Cbturtle2/Location-Declaration-System/Location Declaration System/ID.jpg

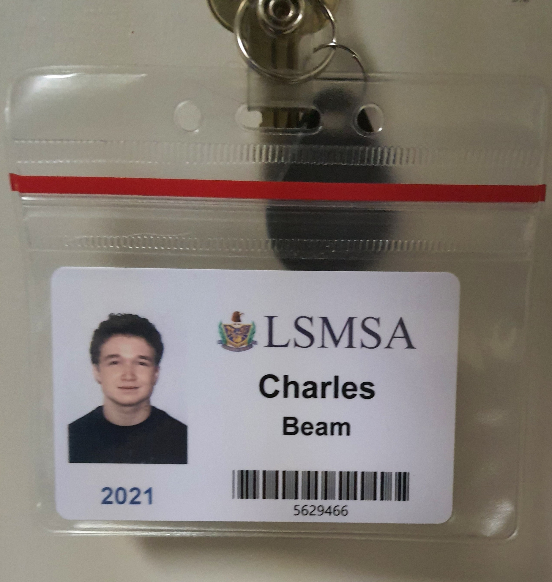
Location Declaration System/ID.jpg
