Cbturtle2/Location-Declaration-System/Location Declaration System/Presenting IBM.jpg

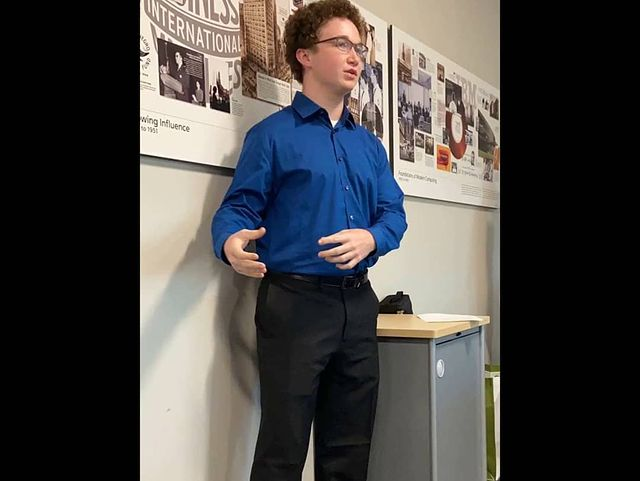
Location Declaration System/Presenting IBM.jpg
