Cbturtle2/Location-Declaration-System/Location Declaration System/RFID Box Inside.jpg

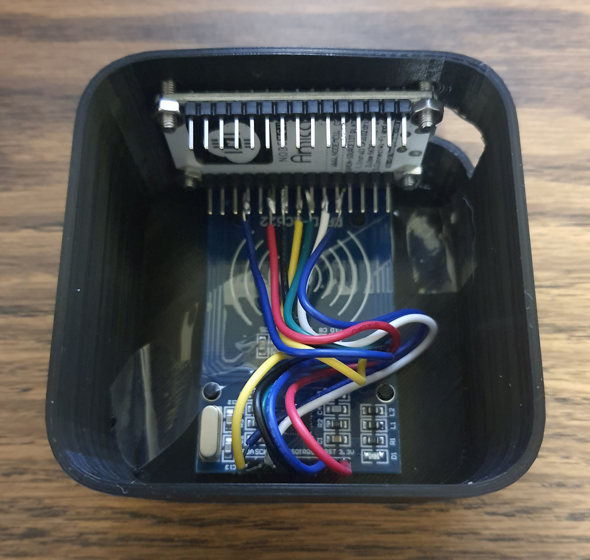
Location Declaration System/RFID Box Inside.jpg
