Cbturtle2/Location-Declaration-System/Location Declaration System/RFID Box LED Angled.jpg

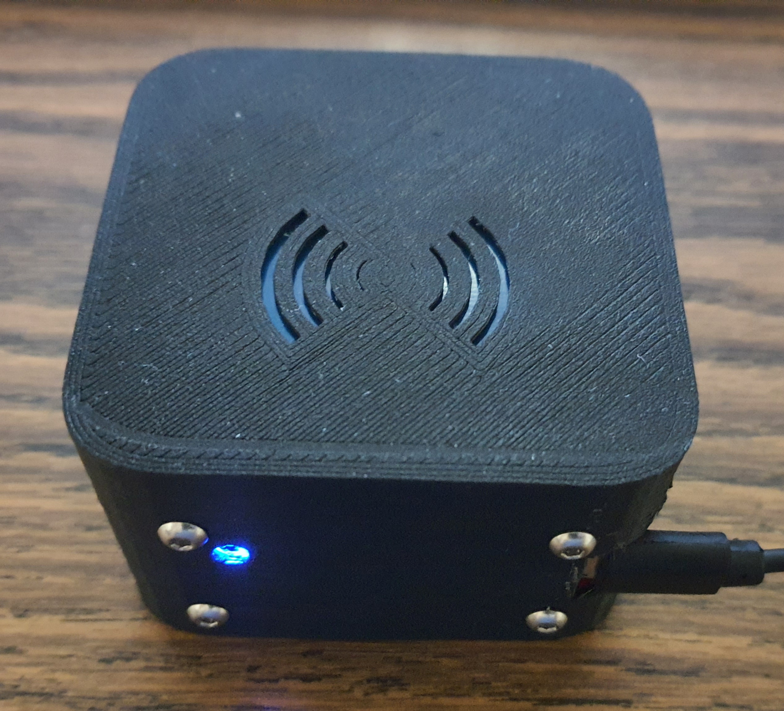
Location Declaration System/RFID Box LED Angled.jpg
