Cbturtle2/Location-Declaration-System/Location Declaration System/RFID Box LED Side.jpg

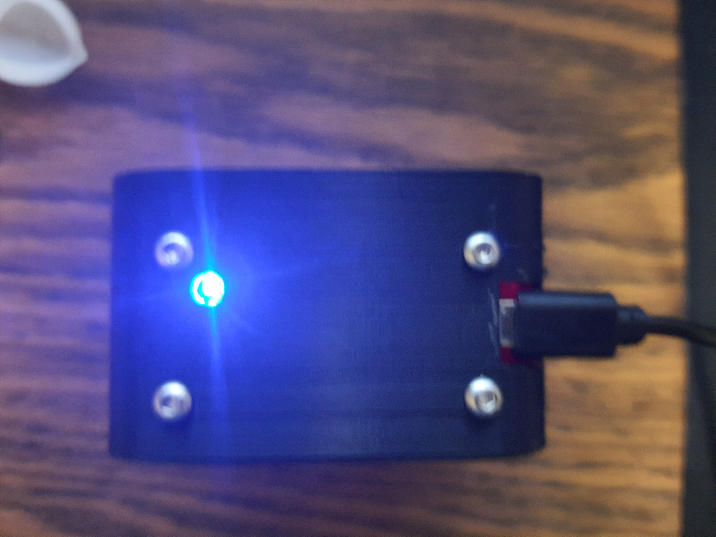
Location Declaration System/RFID Box LED Side.jpg
