Cbturtle2/Location-Declaration-System/Location Declaration System/RFID Box no Box.jpg

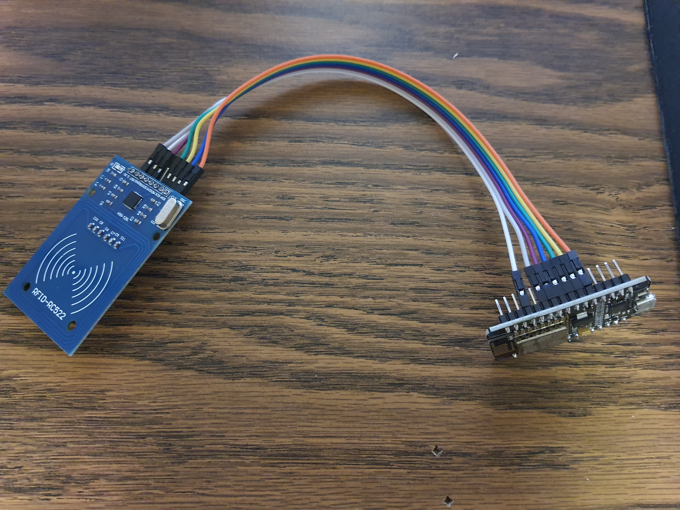
Location Declaration System/RFID Box no Box.jpg
