Cbturtle2/Location-Declaration-System/Location Declaration System/RFID Box Power Port.jpg

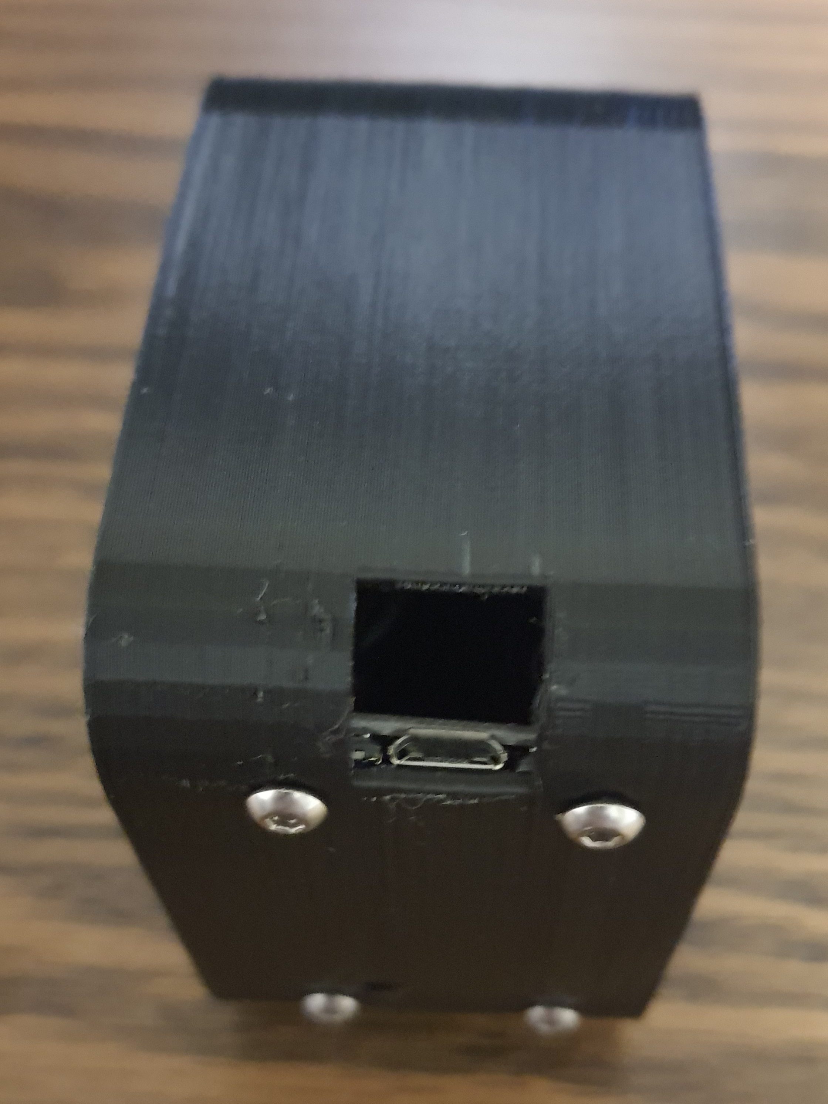
Location Declaration System/RFID Box Power Port.jpg
