Cbturtle2/Location-Declaration-System/Location Declaration System/RFID Box Scanning Area.jpg

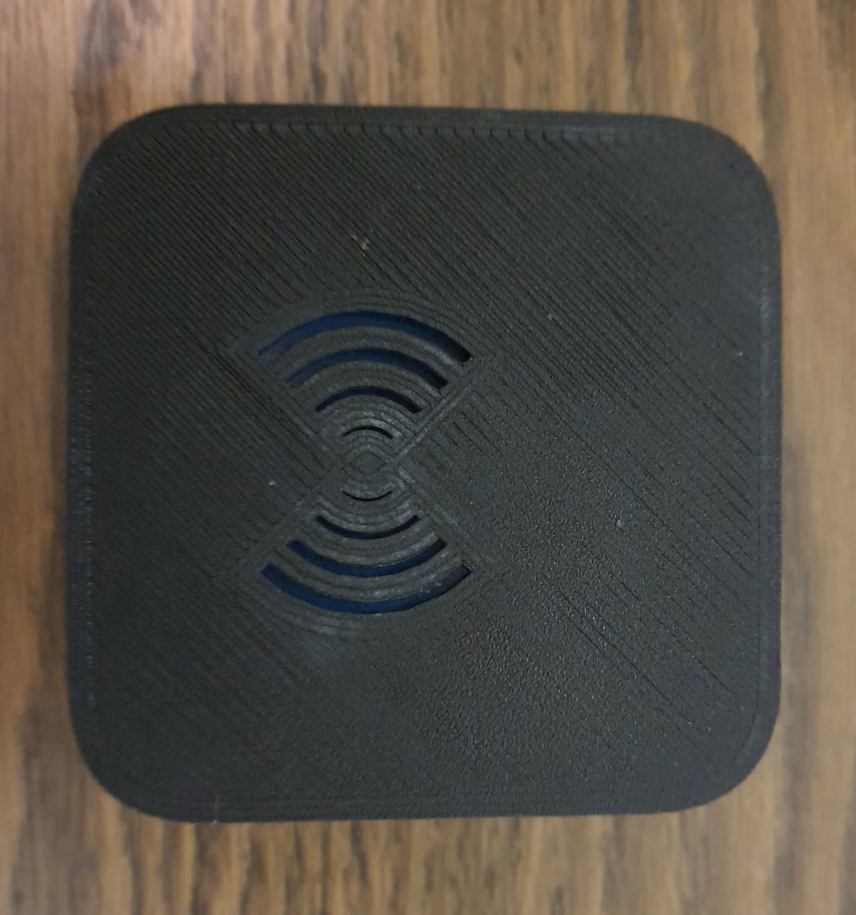
Location Declaration System/RFID Box Scanning Area.jpg
