Cbturtle2/Location-Declaration-System/Location Declaration System/RFID Box.jpg

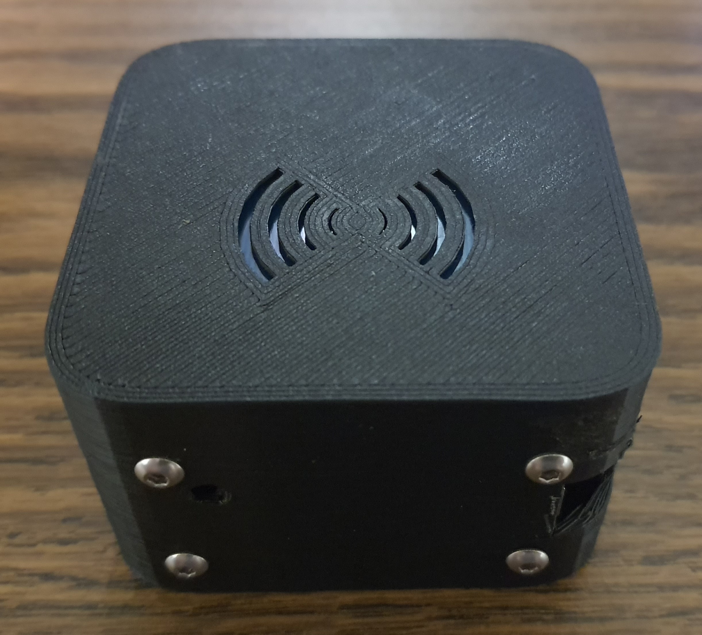
Location Declaration System/RFID Box.jpg
