Cbturtle2/Location-Declaration-System/Location Declaration System/RFID Tag Coil.jpg

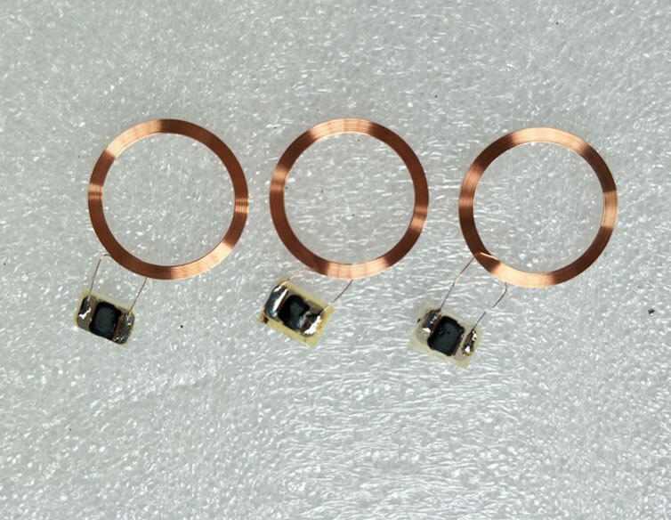
Location Declaration System/RFID Tag Coil.jpg
