Cbturtle2/Location-Declaration-System/Location Declaration System/RFID Tag on Lanyard.jpg

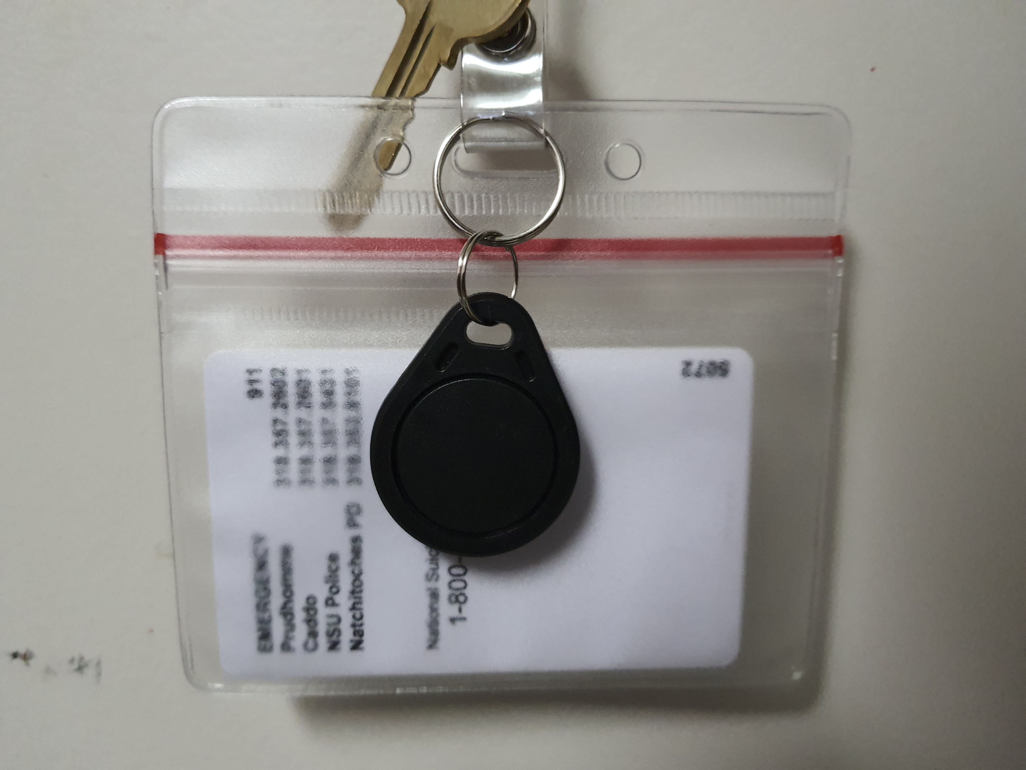
Location Declaration System/RFID Tag on Lanyard.jpg
