Cbturtle2/Location-Declaration-System/Location Declaration System/rfidcard.jpg

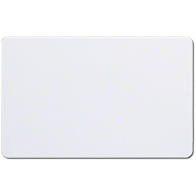
Location Declaration System/rfidcard.jpg
