Cbturtle2/Location-Declaration-System/Location Declaration System/RFID Box Body.stl

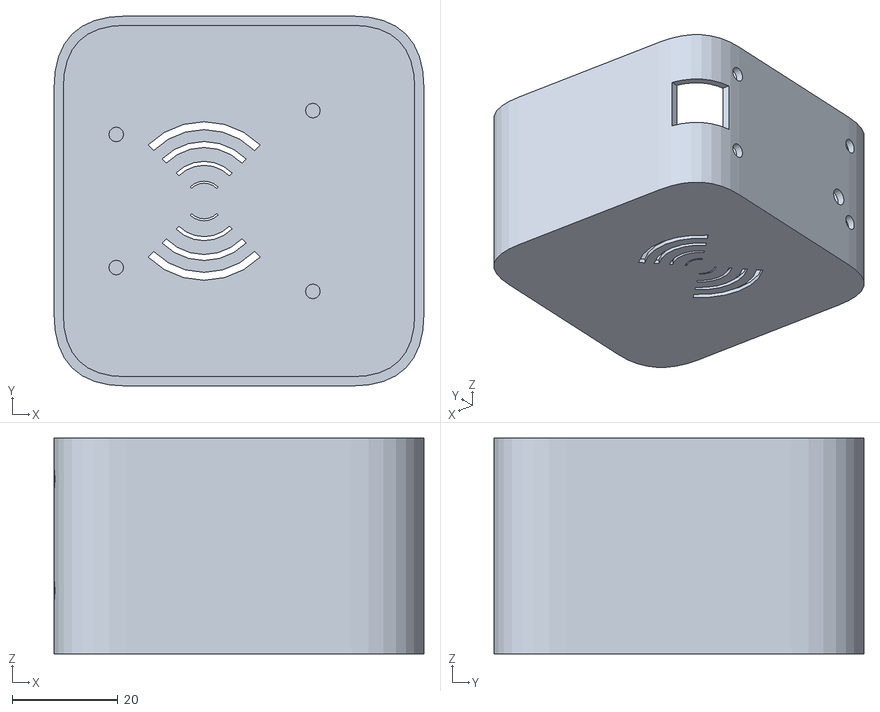
[picture p27: CAD file, 2021-09-23]
Location Declaration System/RFID Box Body.stl
70.0 x 70.0 x 40.8
