Cbturtle2/Location-Declaration-System/Location Declaration System/RFID Box Lid.stl

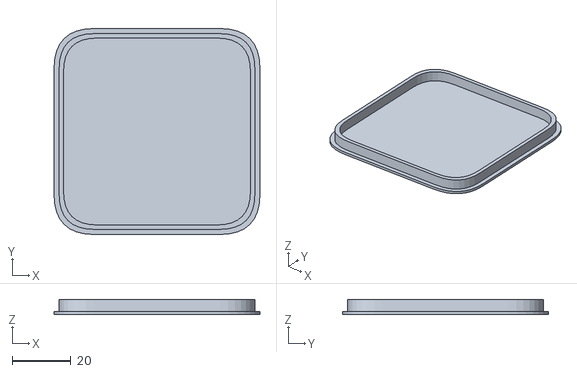
[picture p28: CAD file, 2021-09-23]
Location Declaration System/RFID Box Lid.stl
70.0 x 70.0 x 5.00
