Cbturtle2/Location-Declaration-System/Location Declaration System/OLD Box Bottom.stl

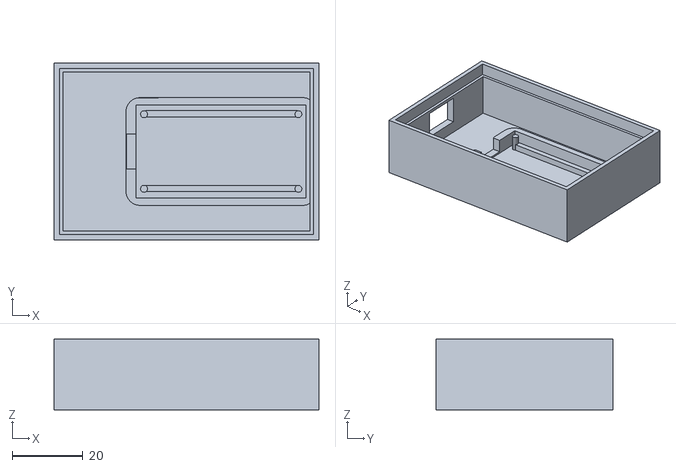
[picture p29: CAD file, 2021-09-23, an earlier design]
Location Declaration System/OLD Box Bottom.stl
75.0 x 50.0 x 20.0
