Cbturtle2/Location-Declaration-System/Location Declaration System/OLD Box Top.stl

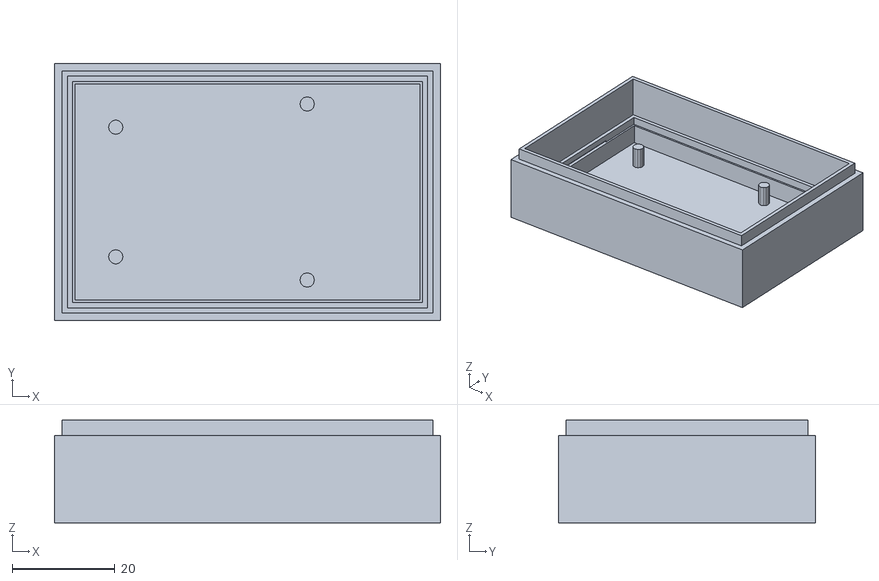
[picture p30: CAD file, 2021-09-23, an earlier design]
Location Declaration System/OLD Box Top.stl
75.0 x 50.0 x 20.0
