Cbturtle2/Location-Declaration-System/Location Declaration System/Soldering Pins Top.jpg

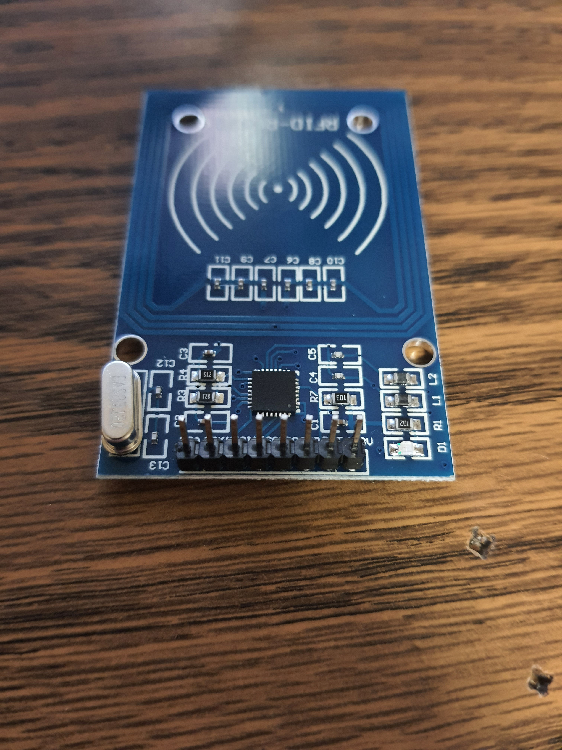
[picture p6: Location Declaration System/Soldering Pins Top.jpg]
Location Declaration System/Soldering Pins Top.jpg
